tsnoad/Reward-Dispenser/(list of files, cad)

Other CAD files:
Reward Dispenser E_mod3.stl
Reward Dispenser F.stl
Reward Dispenser B.stl
Reward Dispenser A.stl
Reward Dispenser E_mod2.stl
Reward Dispenser C.stl
Reward Dispenser D.stl
