tsnoad/Reward-Dispenser/Reward_Dispenser_v2/api_handlers.cpp

#include "api_handlers.h"
#include "wifi_manager.h"

#include "config.h"

#include <Arduino.h>
#include <ArduinoJson.h>
#include <WiFi.h>

#include "stepper_manager.h"
using StepperManager::stepper;

#include "timer_manager.h"

#include "neopixel_manager.h"
using NeopixelManager::pixels;

// ─── State ────────────────────────────────────────────────────────────────────

static bool _helloWorldInProgress   = false;
static uint32_t _helloWorldEndAt    = 0;

// ─── Internal helpers ─────────────────────────────────────────────────────────

static void sendJSON(WebServer& server, int code, const String& body) {
  server.sendHeader("Access-Control-Allow-Origin", "*");
  server.send(code, "application/json", body);
}

static bool parseBody(WebServer& server, JsonDocument& doc) {
  if (!server.hasArg("plain") || server.arg("plain").isEmpty()) {
    sendJSON(server, 400, R"({"ok":false,"error":"Empty body"})");
    return false;
  }
  DeserializationError err = deserializeJson(doc, server.arg("plain"));
  if (err) {
    sendJSON(server, 400, R"({"ok":false,"error":"Invalid JSON"})");
    return false;
  }
  return true;
}

// ─── Tick (called every loop) ─────────────────────────────────────────────────

void APIHandlers_tick() {
  if (_helloWorldInProgress && millis() >= _helloWorldEndAt) {
    _helloWorldInProgress = false;

    if(NeopixelManager::getMessage() == NeopixelManager::Message::HELLOWORLD) NeopixelManager::setMessage(NeopixelManager::Message::NONE);

    Serial.println("[API] Hello World complete.");
  }
}

// ─── Handlers ─────────────────────────────────────────────────────────────────

namespace APIHandlers {
  bool getHelloWorldInProgress() { return _helloWorldInProgress; }

  void dispense(WebServer& server) {
    Serial.println("[API] POST /api/dispense");

    if (StepperManager::getStepperDispenseState() != StepperManager::StepperDispenseState::IDLE) {
      sendJSON(server, 409, R"({"ok":false,"error":"Dispense already in progress"})");
      return;
    }

    StepperManager::startStepperDispense();

    sendJSON(server, 200, R"({"ok":true,"message":"Dispensing"})");
  }

  void helloWorld(WebServer& server) {
    Serial.println("[API] POST /api/helloworld");

    if (_helloWorldInProgress) {
      sendJSON(server, 409, R"({"ok":false,"error":"Hello World already in progress"})");
      return;
    }

    _helloWorldInProgress = true;
    _helloWorldEndAt      = millis() + 4000;

    NeopixelManager::setMessage(NeopixelManager::Message::HELLOWORLD);

    sendJSON(server, 200, R"({"ok":true,"message":"Hello World!"})");
  }

  void timerStatus(WebServer& server) {
    Serial.println("[API] POST /api/timer/status");

    JsonDocument doc;
    doc["ok"]          = true;
    doc["inProgress"]  = TimerManager::getTimerInProgress();
    doc["msRemaining"] = TimerManager::getTimerMsRemaining();
    String out;
    serializeJson(doc, out);

    sendJSON(server, 200, out);
  }

  void timerStart(WebServer& server) {
    Serial.println("[API] POST /api/timer/start");

    if (TimerManager::getTimerInProgress()) {
      sendJSON(server, 409, R"({"ok":false,"error":"Timer already in progress"})");
      return;
    }

    JsonDocument doc;
    if (!parseBody(server, doc)) return;

    int durationMs = doc["durationMs"] | 0;

    if (durationMs <= 0) {
      sendJSON(server, 400, R"({"ok":false,"error":"durationMs must be a positive integer"})");
      return;
    }
    if (durationMs > 3600000) {
      sendJSON(server, 400, R"({"ok":false,"error":"durationMs must be 60 minutes or less"})");
      return;
    }

    TimerManager::startTimer(durationMs);

    NeopixelManager::setMessage(NeopixelManager::Message::TIMER_IN_PROGRESS);

    // sendJSON(server, 200, R"({"ok":true,"message":"Timer Started"})");

    JsonDocument resp;
    resp["ok"]          = true;
    resp["msRemaining"] = TimerManager::getTimerMsRemaining();
    String out;
    serializeJson(resp, out);
    sendJSON(server, 200, out);
  }

  void wifiConnect(WebServer& server) {
    Serial.println("[API] POST /api/wifi/connect");

    JsonDocument doc;
    if (!parseBody(server, doc)) return;

    String ssid = doc["ssid"] | "";
    String pass = doc["password"] | "";

    if (ssid.isEmpty()) {
      sendJSON(server, 400, R"({"ok":false,"error":"ssid required"})");
      return;
    }

    WiFiManager::saveCredentials(ssid, pass);
    sendJSON(server, 200, R"({"ok":true,"message":"Saved. Rebooting…"})");

    delay(500);
    ESP.restart();
  }

  void wifiForget(WebServer& server) {
    Serial.println("[API] POST /api/wifi/forget");
    WiFiManager::clearCredentials();
    sendJSON(server, 200, R"({"ok":true,"message":"Credentials cleared. Rebooting…"})");
    delay(500);
    ESP.restart();
  }

  void wifiScan(WebServer& server) {
    Serial.println("[API] GET /api/wifi/scan");
    String networks = WiFiManager::scanNetworksJSON();
    sendJSON(server, 200, "{\"ok\":true,\"networks\":" + networks + "}");
  }

  void status(WebServer& server) {
    Serial.println("[API] GET /api/status");
    String ssid, pass;
    WiFiManager::loadCredentials(ssid, pass);

    JsonDocument doc;
    doc["ok"]                = true;
    doc["device"]            = DEVICE_NAME;
    doc["firmware"]          = FIRMWARE_VERSION;
    doc["wifi"]["connected"] = WiFiManager::isConnected();
    doc["wifi"]["ip"]        = WiFi.localIP().toString();
    doc["wifi"]["ssid"]      = ssid;
    doc["uptime_ms"]         = millis();

    String out;
    serializeJson(doc, out);
    sendJSON(server, 200, out);
  }

} // namespace APIHandlers
