tsnoad/Reward-Dispenser/(commit log)

2026-08-17 fix stepper setup so it actually turns the correct amount
    [api_handlers.cpp, config.h, stepper_manager.cpp]
2026-08-17 fix interface so it scans for APs and shows the current AP. note these fixes were guided by Claude
    [api_handlers.cpp, web_server.cpp, wifi_manager.cpp]
2026-08-17 use mdns so device can be reached at http://DEVICE_NAME.local
2026-08-17 add openscad model and printable STL files
    [Reward Dispenser A.stl, Reward Dispenser B.stl, Reward Dispenser C.stl, Reward Dispenser D.stl, Reward Dispenser E_mod2.stl, Reward Dispenser F.stl, Reward Dispenser.scad]
2026-08-17 add helper library
    [Reward Dispenser.scad, component_a4988.scad, component_ddc612sa.scad, component_esp32c3.scad, component_stepper_nema17.scad]
2026-08-18 clean up model
    [Reward Dispenser.scad]
2026-08-18 change pin number to match new wiring harness, and fix microstepping multiple handling
    [api_handlers.cpp, config.h, stepper_manager.cpp]
2026-08-18 more useful alignment marks for picking spool
    [Reward Dispenser.scad]
2026-08-18 huge refactor
    [Reward Dispenser E_mod3.stl, Reward Dispenser.scad]
2026-08-18 add a hello world api endpoint that we can use to check if the device is responding and get a visual que back
2026-08-18 add a readme with some wiring information
2026-08-19 switch to using platformio to compile the binaries in the GH action. more heavy use of Claude here
2026-08-19 wtf, ESP32-C3 Arduino prevents me from defining ESP_NEOPIXEL?????
    [Reward_Dispenser_v2.ino, config.h, neopixel_manager.cpp, stepper_manager.cpp]
2026-08-20 first steps to add a timer function
2026-08-20 have the web interface show the timer status. note this was guided by Claude
2026-08-20 make the timer look nicer. heavy use of claude here
2026-08-20 move stepper managment into stepperManager and out of APIHandlers, this is so we can dispense from timermanager, and remove or block dispensing directly from the api
2026-08-20 dispense at the end of the timer
2026-08-20 make sure the neopixel message doesnt just set to NONE if there is an ongoing state it needs to be reset to
    [Reward_Dispenser_v2.ino]
