tsnoad/Reward-Dispenser/(notices)

Notices in the files:
README.md:
[License: CC BY 4.0](https://creativecommons.org/licenses/by/4.0/)
